jorgerazura26-gif/semi-automated-food-packaging-station/Electronic and Pneumatic Diagrams/Pneumatics.jpeg

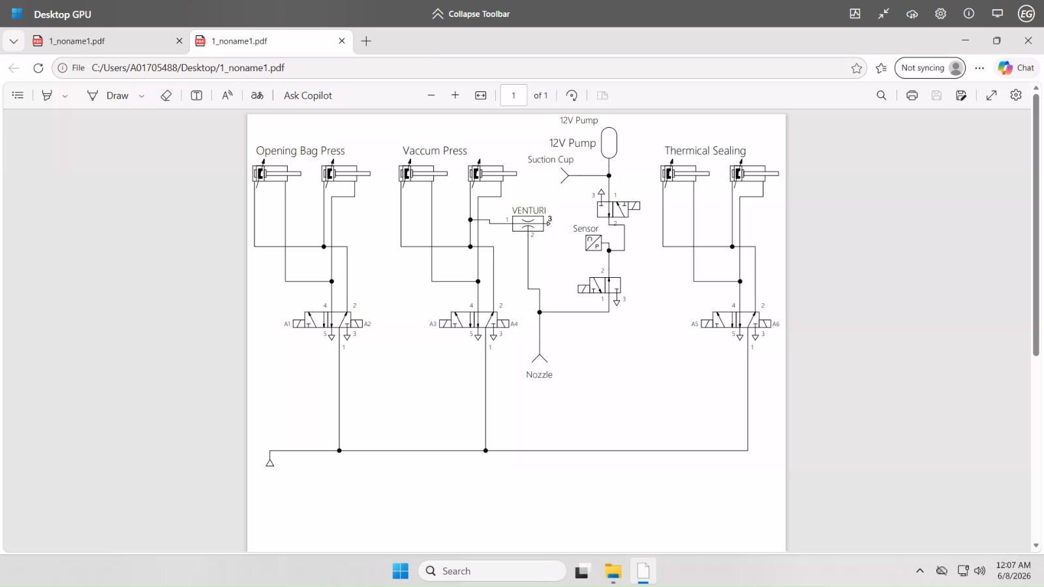
Electronic and Pneumatic Diagrams/Pneumatics.jpeg
