jorgerazura26-gif/semi-automated-food-packaging-station/(list of files, drawings)

Other design files:
Electronic and Pneumatic Diagrams/Dosing_System.pdsprj
